nshian/EPP1/README.md

# CG1111A Engineering Principles and Practice I AY21/22 S1
